paynterf/my_vision_robot/docs/WallE_hotel_Pi5_connection_session_2026-11-04.docx

# Connecting to the Pi 5 from a Hotel Room

Near-verbatim session memorial — 4–6 November 2026

Human = operator, Grok = assistant. Covers direct Ethernet, serial-bridge attempt, cmdline.txt static IP, VS Code Remote-SSH, and iPhone hotspot.

## Initial problem

Human: I'm trying to connect to the Pi5 from my laptop in a hotel room, and it's not working. I suspect this is because the Pi5 wireless adaptor isn't connected to the internet (I was using a local LAN connection in my home). What are my options to get connected?

Grok: You’re right that the Pi is almost certainly still on (or expecting) your home LAN and has no route to the hotel network. Options in order of ease: (1) put the Pi on the hotel Wi-Fi or a phone hotspot, (2) direct Ethernet cable with static IPs, (3) USB gadget mode if pre-configured, (4) pre-arranged Tailscale/ZeroTier. Fastest with a cable is direct Ethernet; fastest with only Wi-Fi is a phone hotspot.

## Direct Ethernet cable

Human: I don't have any cables, but I can get some (I hope). If I have a direct-connect ethernet cable to my laptop, will that be enough to get going?

Grok: Yes. A single ordinary Ethernet cable is enough. Both ends need an IP on the same subnet. Easiest if you can touch the Pi: set 192.168.4.1/24 on eth0 and 192.168.4.2 on the laptop. If you cannot touch the Pi, many systems fall back to link-local (169.254.x.x) and raspberrypi.local may work.

Human: no keyboard/monitor available (unless the laptop can be made into one)

Grok: The laptop cannot become a keyboard+monitor over plain Ethernet. You are limited to a pure network connection. Raspberry Pi OS normally runs Avahi; after plugging the cable try ping raspberrypi.local or scan the 169.254.0.0/16 range. If nothing answers, eth0 is down and you need one-time console access.

## HDMI capture and one-cable reality

Human: you mentioned an HDMI capture device. If I have/get one of those, will that allow me to access the Pi5 via my laptop keyboard/monitor?

Grok: An HDMI capture device gives you the monitor half only. HDMI does not carry keyboard/mouse back to the Pi. You still need a USB keyboard plugged into the Pi (or another input path) to type.

Human: so the best one-cable option is direct ethernet and hope I can ping/connect to the Pi5?

Grok: Yes. With only one cable and no keyboard/monitor, direct Ethernet + hoping for link-local / raspberrypi.local is the best practical option. If nothing responds, you need one-time console access.

## Link-local troubleshooting (after receiving/connecting Ethernet adaptor/cable)

Human: [Windows ipconfig showing Ethernet 2 at 169.254.90.85] ping raspberrypi.local → “could not find host”

Grok: Windows has a link-local address so the cable is linked, but Windows has no mDNS/Bonjour so raspberrypi.local fails. Check arp -a, ping the broadcast 169.254.255.255, or scan with PowerShell. Any answering address can be used with ssh.

Human: [arp -a shows only broadcasts/multicasts on 169.254.90.85]

Grok: No other device is answering at layer 2. Check link lights, reseat the cable, power-cycle the Pi. If ARP stays empty, eth0 is not coming up by itself.

Human: Link light on the Pi5 is ON (blinking). Laptop end is USB-C (no light). Pi5 link light blinks when I ping raspberrypi.local.

Grok: Cable and Pi port are electrically alive. The USB-C Ethernet adapter is the weak link. Confirm it is Ethernet 2, disable power management, try broadcast ping, or set a static address outside the 169.254 range.

## Static IP experiments

Human: [netsh static 169.254.90.10 failed without admin; later with admin produced “PING: transmit failed. General failure.”]

Grok: Windows rejects transmit when you manually assign an address inside the special 169.254.0.0/16 APIPA range. Use an ordinary private subnet instead: netsh interface ip set address "Ethernet 2" static 192.168.4.2 255.255.255.0

Human: [After setting 192.168.4.2, pings to 192.168.4.1 and broadcast time out; arp -a still empty of Pi MAC]

Grok: Laptop side is now working correctly. The Pi simply has no address on 192.168.4.0/24, so it will not answer ARP. The cable is fine; you need one-time console access to give eth0 an address.

## Teensy serial bridge attempt

Human: I actually have a serial adapter - of a sort. I have a USB cable to my Teensy, and the Teensy is connected to Serial1 on the Pi5. Can we generate a teensy program to set the Pi5 ethernet address?

Grok: Yes if a serial getty is running on that UART. Upload a bridge sketch that forwards bytes between Serial (USB) and Serial1. Then use PuTTY on the Teensy’s COM port. If a login prompt appears you can set the IP.

Human: [PuTTY “Access is denied” because Visual Micro had the port open; later black screen, no response to Enter]

Grok: Port is free once Visual Micro shows “Port closed.” Silence usually means no serial console, baud mismatch, or WallE_5.py already owns the port.

Human: I think we forgot that the Pi5 is running the WallE_5.py script from bootup, and it owns the serial port

Grok: Correct. WallE_5.py keeps the UART open, so the bridge cannot give you a shell. Remaining options: mini-HDMI + keyboard, USB-serial on GPIO, or edit the SD card.

## SD card cmdline.txt static IP

Human: OK, I have the SD card plugged into my laptop. It shows up as 'system-boot (D:)'

Grok: That is the FAT32 boot partition. Append to cmdline.txt (single line): ip=192.168.4.1::192.168.4.1:255.255.255.0:raspberrypi:eth0:off The kernel will assign the address at boot.

Human: [Shows cmdline.txt with the ip= parameter added]

Grok: Looks correct. Eject, boot the Pi with the cable connected, then from the laptop (192.168.4.2) ping/ssh 192.168.4.1.

Human: [Screenshot of successful SSH: Welcome to Ubuntu 24.04.4 LTS, pi@RobotPi5:~$]

Grok: You’re in. The ip= parameter worked. You can make it permanent with nmcli or simply leave the cmdline.txt line. Pull the latest code and restart WallE when ready.

## cmdline.txt downsides and VS Code

Human: is there any downside to leaving the ip= line in cmdline.txt?

Grok: Very little for this use case. It overrides DHCP on eth0 only (Wi-Fi unaffected) and is not managed by NetworkManager. Fine to leave for the direct-cable address.

Human: I'm still locked out of VS Code because the Pi5 wifi isn't connectable to the hotel net, correct?

Grok: No. VS Code Remote-SSH works over the Ethernet link. Connect to pi@192.168.4.1. The Pi does not need hotel Wi-Fi for editing.

Human: [VS Code screenshot showing SSH: 192.168.4.1 and WallE_5.py open]

Grok: Connected. Note that the visible terminal may be local; open a new terminal while the remote window is focused to get a shell on the Pi.

## No internet on the Pi / scp

Human: git fetch → fatal: unable to access 'https://github.com/...': Could not resolve host: github.com

Grok: The Pi has no internet path. Options: phone hotspot, Internet Connection Sharing from the laptop, or scp the file from the laptop. For a quick update of WallE_5.py, scp is fastest.

Human: doesn't the scp command need the full laptop path to WallE_5.py as well?

Grok: Yes. Run scp on the laptop with a valid source path, e.g. scp C:\Users\Frank\Documents\Robot_Projects\my_vision_robot\software\scripts\WallE_5.py pi@192.168.4.1:~/my_vision_robot/software/scripts/

Human: [Pastes the full WallE_5.py from the Pi, containing the !STUCK_ACK and !STUCK_CLEAR handshake]

Grok: The copy worked. Handshake code is present and syntactically correct. Restart WallE when ready; Pi and Teensy sides are now aligned.

## iPhone hotspot for untethered testing

Human: I ran into another problem now that I have the PI5 & teensy software aligned. In order to connect the Pi5 to my laptop VS Code I have to have the ethernet cable connected to the laptop, which severely limits how I can test. You mentioned something about using my phone as a local wifi hotspot. Is that a real possibility?

Grok: Yes. Turn on the phone hotspot, nmcli connect on the Pi, then SSH/VS Code from the laptop (also on the hotspot) to the Pi’s 172.20.10.x address. Ethernet can be unplugged once that works.

Human: Will that same trick work with the laptop-Pi5-phone setup; PI5 connects to phone hotspot via wireless, but laptop connects to hotspot via USB-to-iPhone cable connection?

Grok: Yes. On an iPhone the USB-tethered laptop and Wi-Fi hotspot clients share the same 172.20.10.0/28 subnet and can see each other. Laptop internet may prefer the phone; adjust interface metrics if you want hotel Wi-Fi to stay primary.

Human: [nmcli connect “Frank” → No network with SSID 'Frank' found; later scan shows no Frank until Maximize Compatibility]

Grok: Enable Maximize Compatibility on the iPhone (forces 2.4 GHz), toggle hotspot, rescan. Then connect to the stronger WPA2 “Frank” entry.

Human: sudo nmcli dev wifi connect "Frank" password "abc12345" → Device 'wlan0' successfully activated

Grok: Connected. Get the address with ip -4 addr show wlan0, then from the laptop ssh pi@172.20.10.x and point VS Code at the same address. Ethernet cable can come out.

End of memorial. Outcome: direct Ethernet + cmdline.txt ip=192.168.4.1 gave initial SSH/VS Code access; iPhone hotspot (Maximize Compatibility) later provided an untethered path. Handshake code confirmed present on the Pi.
