paynterf/my_vision_robot/docs/WallE_stuck_ahead_handshake_session_2026-11-02.docx

# WallE Stuck-Ahead Debugging & Handshake Implementation

Session memorial — 1–2 November 2026

Near-verbatim record of the debugging conversation. Human = operator, Grok = assistant.

## Opening

Human: This is a continuation of the previous chat, aimed at debugging issues with 'stuck_ahead' processing.

Grok: The stuck-recovery branch is present on the repo. I checked out the current code on that branch and reviewed the relevant sections. [Summary of Teensy RunToDaylightV2 scan + Pi get_stuck_ahead_recovery_heading flow.]

## Floor-run logs and zero distances

Human: New floor run. It appears the stuck_ahead detection and initial motion sequence (stop/reverse/backup/stop) worked OK, but the scan was only partially successful. ... The telemetry.log shows that the first 36 scan output lines look OK, but then the remainder show all zeros for distance. [Full nav.log and telemetry.log excerpts provided.]

Grok: The backup sequence worked cleanly. The scan itself completed, but the front VL53L1X stopped producing valid ranges roughly halfway through the 72-step (5°) spin. First ~36 samples look normal; starting at timestamp 147823 the distance field becomes 0.0 and stays 0.0. Because the open lobe happened to fall in the good half, get_stuck_ahead_recovery_heading still picked a usable middle heading (–145.1°).

## Midpoint / ±180 fold correlation

Human: good analysis, but it doesn't explain why the zero distance readings occur exactly at the midpoint of the scan; that can't be coincidence

Grok: You’re right — it is not a random timeout. It is exactly at the ±180° wrap, which is also the exact midpoint of the 72-step scan. Exactly 36 non-zero readings, then 36 zeros. Last good: 147623 348.9 –179.1; first zero: 147823 0.0 177.3. Starting heading ≈ –4°. 36 × 5° CCW = 180°. The SpinTurn that carries the heading across the fold is the first one that leaves the sensor in the timed-out state.

## UpdateIMUHdgValDeg discussion

Human: How does a heading across the fold possibly influence the sensor itself? Isn't it more likely there is a bug in UpdateIMUHdgDeg()?

Human: why are these two 'while()' statements 'while()' statements instead of 'if' statements? [folding continuousDeg into ±180]

Grok: Those two while loops fold an arbitrarily large unwrapped angle back into [–180, +180]. continuousDeg is an accumulating sum; after many revolutions it can be far outside ±180. A single if would only handle one wrap. The while makes the fold robust. They cannot produce a delay that would affect the VL53L1X (pure floating-point, microseconds at most).

## Root cause: Stuck_Ahead spam

Human: I discovered that the 'Stuck_Ahead' alert from the Teensy was occurring every 50mSec or so, and that was causing most if not all of the issues we were seeing. To address this, I added [STUCK_AHEAD_PRINT_INTERVAL_MSEC = 1000 and rate-limit check]. After these changes, the 'fold' issues disappeared and now scans run correctly. However, this points up a system issue. We already have [recovery_in_progress guard on the Pi]. I think the real solution is to have a handshake arrangement where the Pi5 tells the teensy that it has received the 'Stuck_Ahead' notification and to stop sending these messages.

Grok: The spam diagnosis fits the symptoms perfectly. A !Stuck_Ahead every 50 ms was flooding the serial link and the Pi’s telemetry thread. Rate-limiting to 1 Hz is a solid immediate fix. A real handshake is the cleaner long-term solution. Recommended: Teensy emits only when status is AUTO_NAV (and rate-limited); Pi sends !STUCK_ACK immediately; Teensy sets STATUS_STUCK_AHEAD; after recovery Pi sends !STUCK_CLEAR.

## Switching to AnomalyCode

Human: Looking through my teensy code, it occurs to me that I already have a 'status' code for 'stuck_ahead/behind' with [AnomalyCode enum]. So I think my addition of the 'gl_SystemStatus' object is duplicative and should be dropped. ... I like the idea of a separate "!STUCK_ACK" command... I don't think separate "!STUCK_AHEAD_ACK" and "!STUCK_BEHIND_ACK" commands are required.

Grok: Dropping gl_SystemStatus in favor of the existing AnomalyCode is reasonable. Suggested protocol using gl_AnomalyCode: emit only when ANOMALY_NONE + rate limit; !STUCK_ACK sets ANOMALY_STUCK_AHEAD; !STUCK_CLEAR sets ANOMALY_NONE. Points to watch: manual-mode early-out still needs a replacement; only the Pi should clear the anomaly; optional 60 s safety timeout.

## Risks of dropping gl_SystemStatus

Human: What are the specific risks of dropping gl_SystemStatus?

Grok: Live uses are few but two are load-bearing: (1) loop() early-out for manual/firmware-update — high risk if dropped without replacement; (2) scan abort inside RunToDaylightV2 on manual command — medium risk. Temporary STATUS_STUCK_AHEAD around the scan is low-risk once AnomalyCode handshake is in place. Mitigation: replace with a simple bool gl_bManual or use ANOMALY_MANUAL_CONTROL.

## Header move and compile issues

Human: I have decided to go back to an included 'enums.h' (renamed), but I'm having trouble getting it to compile. [Screenshot of Visual Micro Deep Search error.]

Grok: The failure is happening before the compiler even looks at your code — Visual Micro ‘Deep Search’ library discovery error. Practical fixes: clear %LOCALAPPDATA%\Arduino15\staging and Temp\VMBuilds; turn off Deep Search; ensure header is in the sketch folder; simplify the header guard to just #pragma once.

## Git commit / diff workflow

Human: I am getting ready to commit the latest firmware update to Github. ... the 'diff' now showed NO CHANGES! How do I view the actual changes between the Github repo and my (staged but not committed) files?

Grok: Once everything is staged, plain git diff is empty by design. Use git diff --cached (or --staged) to see staged changes vs HEAD. In Visual Studio, ‘Compare with Unmodified’ diffs working tree vs HEAD (shows all local changes); ‘Compare with Index’ shows only unstaged.

## Review of commits

Human: OK, I think I got the latest firmware update committed/pushed. Can you take a look at the Github repo and tell me what I got wrong or missed?

Grok: Commit 5e65691: real bug in new header — enum/array mismatch (ANOMALY_MIRRORED_SFC still in enum, string array dropped it). gl_SystemStatus was not removed. Rate limit and IMU correction restore look correct.

Human: good points - I fixed the enum index issue. regarding gl_SystemStatus vs gl_AnomalyCode; I've changed from gl_SystemStatus to gl_AnomalyCode, but wonder if I should also keep the 'FIRMWARE_UPDATE' status/code (make it another entry in the AnomalyCode enum?

Grok: No — you do not need to add FIRMWARE_UPDATE. It is never assigned in live code; the ‘U’ handler calls update_firmware() which does not return on success and reboots on failure. Drop it.

## Final handshake implementation

Human: So in the 'M' case, this needs to be: gl_AnomalyCode = AnomalyCode::ANOMALY_MANUAL_CONTROL; and in the 'A' case: gl_AnomalyCode = AnomalyCode::ANOMALY_NONE; Does that look correct? [Then proposed !STUCK_SCAN clearing immediately.]

Human: I like the latter approach, with full handshaking. We are not concerned about about speed at all - just consistency and robustness

Grok: Full handshake: Teensy emits only when ANOMALY_NONE + rate limit. !STUCK_ACK sets ANOMALY_STUCK_AHEAD. !STUCK_SCAN sets it (idempotent) and does not clear. !STUCK_CLEAR is the only place that sets ANOMALY_NONE. Pi sends ACK first, then backup + SCAN, then CLEAR after turn/restart.

## Commit reviews and Visual Studio notes

Human: should be up on GitHub. Can you please check?

Grok: Commit 0aa3bd7 looks correct. Header mismatch fixed, full handshake commands present, SystemStatus removed, M/A and scan-abort updated. Minor: print strings still say “System Status”; Pi side not yet updated in this push.

Human: I've noticed that the Visual Studio version of 'commit/push' seems to bypass 'fetch/status/pull/status'. Is that an issue?

Grok: Yes, it can be an issue if the remote has moved. VS Commit/Push does not automatically fetch or pull. Fine when you are the sole committer and recently pulled; otherwise fetch first.

Human: [Diff view screenshot] This is the Visual Studio 'diff' view, but it doesn't seem to offer an easy way to go from there to the 'changes' page... Am I missing an easier way?

Grok: No hidden button on the diff tab. Fastest: Ctrl+0, G then C, or Git → Commit or Stash…. Dock the Git Changes window so it stays available.

Human: oooh, thanks - I docked it into the bottom of the Solution Explorer window

## Final commits and close

Human: the last changes should be up on Github

Grok: Commit cc73fb2: three print-string updates only. One nit: commented line used AnomalyCodeStrArray instead of AnomalyStrArray.

Human: No, I meant it has already been fixed and should be up on Github - sorry for the confusion

Grok: Confirmed. Commit b073ab6 fixes the commented line to AnomalyStrArray. Name matches the header.

Human: This evening's work was kind of fun. I've never been able to iterate through things at all quickly like this. Having you watching over my shoulder is really powerful.

Grok: Glad it felt that way. The tight loop—change, push, review, next fix—works well when both sides can see the same repo state quickly.

End of memorial. Key outcome: Stuck_Ahead spam identified as root cause; full handshake implemented on Teensy using AnomalyCode (!STUCK_ACK / !STUCK_SCAN / !STUCK_CLEAR); SystemStatus removed; rate-limit retained as backstop.
