paynterf/my_vision_robot/docs/WallE_best_direction_discussion_2026-10-09.docx

WallE floor-test discussion

Best direction after TOO_CLOSE

9 October 2026

Verbatim discussion, beginning with the 15° scan-interval note. Speaker labels are added. The wording is otherwise as sent.

# Discussion

Human

After thinking about it, I'm not sure the 15 deg scan intervals will help much. As you pointed out yesterday, the FOV overlap even at 45 deg intervals means a 15 deg scan interval will not provide any additional information.

Human

Thinking aloud here; the problem we are trying to solve is "what is the best direction to move after encountering a 'too close' obstacle"? We use the OAK-D Lite camera to produce a coarse 2D (off-angle and depth) array. From this array we select the best off-angle/depth pair for each orientation in an 8-position (initial heading plus seven 45 deg scan steps). At the end of the scan we have a catalog of robot headings /best-depth pairs. From that we pick the best depth and tell the robot to turn to the associated heading. We have found so far that this algorithm doesn't always pick the 'correct' heading in an office environment with lots of clutter, but with an obvious open direction with an approximately 7m clear run. This leads me to believe that either we do not have a good definition of 'best direction’ or our sensor is incapable of distinguishing between 'under the desk past my legs' and 'doorway 7 meters away', or we are not utilizing our sensor information appropriately. As you just mentioned, a better 'best direction' definition might be your "A direction worth driving is the heading whose central strip is far, and whose neighbors are also far. One bright pixel at the edge of the frame is not that."

Grok

The 15° scan would mostly resample the same frames. With a 72° stereo field of view, a stop already sees the neighbor's scene, so tighter steps add copies, not a new direction.

Grok

The break is in what "best" means. The catalog keeps the farthest pixel in each frame, then turns to the heading that held the single largest of those. In this room that pixel is often a gap under a chair, or the doorway already in the edge of the frame, one stop before the robot is aimed at it. A 7 m clear run only wins if some frame's farthest pixel happens to be that run, and the heading stored with it happens to be the one pointing down it.

Grok

So the two separate faults are the score and the pairing. The score is "farthest pixel anywhere," not "longest clear path straight ahead." The pairing is the heading filed with that pixel, which across the three runs did not stay on the doorway: 3379 mm, 1386 mm, and 1772 mm for the same south opening.

Grok

A direction worth driving is the heading whose central strip is far, and whose neighbors are also far. One bright pixel at the edge of the frame is not that.

Human

Human

This leads to the conclusion that just picking the 'best-depth' associated with a scan stop is not sufficient for robust 'best-direction' determination. The good news; we actually have more information available from even the coarse algorithm we are currently using. Each 'best-depth' value is also paired with an 'off-angle' value that denotes how far off from the camera's central axis the best-depth value is located - this is what we use for 'tweak right'/'tweak left' adjustments. So, if we wished, we could replace the single 'best-depth' value in our scan catalog with an array containing *all* of the depth values available for each scan position. Due to the overlap caused by a 45 degree scan interval and a ~70 FOV, we might even be able to stitch the separate depth value arrays into a more-or-less seamless 'horizon depth array' that could make finding the real 'best direction' much more robust.

Human

As a possible variation on your "A direction worth driving is the heading whose central strip is far, and whose neighbors are also far. One bright pixel at the edge of the frame is not that." In my old robot's firmware I used a mathematical variance calculation of front & rear distance values to robustly determine when the robot was stuck; during normal operations, the front and rear distances vary linearly as the robot tracks a wall. When the robot gets stuck, the distances no longer vary. A variance calculation at each pass through the navigation loop will detect 'stuck' by noting that the variance has decreased below some threshold. If we were to construct the 'more or less seamless' array of depth values around the horizon, the 'best direction' would be the one that has a relatively smooth progression of depths up to peak and down again.

Human

So, to summarize my ramblings; I propose that we utilize the entire (or a subset of) the 'horizon' depth value array available from the camera at each scan orientation to make a better determination of 'best direction'.

Human

One other off-beat but possibly relevant piece of data. We actually have a second independent distance sensor in the rear-facing VL53L1X IR TOF sensor. Maybe it could be used as a sanity check and/or a way to filter out the 'under the chair past my legs' orientation.

Human

Thoughts?

Grok

The horizon array is the right next representation. The single best-depth is what has been losing, and you already have the off-angle that says where that pixel was.

Grok

A stitched circle is only as good as the heading on each frame. That pairing is the thing the three runs did not hold: the doorway came back as 3379 mm, 1386 mm, and 1772 mm. If a frame is filed one stop off, stitching smears the 7 m opening into the wrong sector and makes the miss look smooth. Per stop, keep the angle-and-depth samples in camera axes. Convert to world heading only after the H for that stop is in. Do not stitch until a stop aimed at the doorway keeps the long reading.

Grok

The variance idea is the part that rejects the chair gap without stitching. A doorway is a wide lobe: several off-angles far, and the neighbors far too. Under the desk is a narrow spike, one far pixel with near pixels beside it. Score each stop by the width of the far region around the center, not by the maximum. The peak of a smooth run is the direction. A lone 2968 mm at the edge of the frame loses.

Grok

The rear VL53L1X can be a veto, not the selector. It is one narrow beam, 180° from the camera. At a real doorway stop the camera's central strip is far and the rear beam is the wall just backed away from. At the legs stop the camera's far pixel is off-axis and the rear beam is not a wall. Sample it at the same pause as the H. If the rear range is long too, that stop is a gap, not an exit.

Grok

So the catalog row becomes the central depth, the width of the far region, and the rear range. The winner is the wide, central, rear-near stop. The 15° scan can wait until that score picks south on a 45° run.

Human

"The rear VL53L1X can be a veto, not the selector. It is one narrow beam, 180° from the camera. At a real doorway stop the camera's central strip is far and the rear beam is the wall just backed away from. At the legs stop the camera's far pixel is off-axis and the rear beam is not a wall. Sample it at the same pause as the H. If the rear range is long too, that stop is a gap, not an exit."

Human

I like the 'veto' idea, but it's not just a veto. When the robot is pointing away from the doorway, the rear sensor is pointing toward it. A good measure of 'best-direction' would be the direction that produced multiple far-distance values in that (or adjacent?) scan stop *and also* with a correlated high distance value from the rear sensor reading associated with the opposite scan direction (i.e. the scan direction where the rear sensor is pointed in the same direction as the 'best-direction' candidate). Maybe that is really the same as the 'veto' idea - inverted?

Human

Also, since the VL53L1X is very fast, we could actually use it to produce a much more granular map of a candidate direction by rotating the robot 180 deg and smoothly rotating the robot through the directions of interest. And now that I think about it- that sensor doesn't have to be rear-facing; I could just as easily mount it facing in the same direction as the camera, and then it becomes an accessory-during-the-fact collaborator.

Human

"The winner is the wide, central, rear-near stop" I believe you let an assumption sneak into this sentence; the 'best-direction' doesn't have to be 180 degrees from the obstacle. The robot could just as easily hit a chair just past a long hallway, where the 'best-direction' is 90 degrees from the obstacle orientation. In the limit, think of a 'Tee' intersection (except the horizontal cross-bar is longer than the vertical portion) where the robot is traveling from the bottom of the 'Tee' toward the top. the robot reaches the top of the T intersection and hits the far side. Then *either* 90 degree direction would work> So the catalog row becomes the central depth, the width of the far region, and the rear range. The winner is the wide, central, rear-near stop. The 15° scan can wait until that score picks south on a 45° run.

Grok

Yes. The rear-near rule was the wrong geometry. It only fits this room, where the robot backed off a wall and the doorway was behind it. At the top of a T, both exits are 90° from the wall it hit, and the rear beam at either exit stop is the other exit, not a wall. A long rear reading there would veto the right answer.

Grok

The useful pairing is the opposite stop. A candidate heading is confirmed when the camera's wide central lobe points that way and the rear beam, taken at the stop 180° around, also sees far down that same line. That is the veto inverted: the rear sensor votes for a direction while it is aimed at it, not while the camera is. Adjacent stops can vote too, since the beam is narrow and a stop may not land on the opening.

Grok

Mounting it forward makes that simpler. It then samples the same direction as the camera, at the same pause as the H, and a far central lobe plus a far beam is one stop instead of a pair. A smooth 180° sweep with the VL53L1X is a good way to draw the lobe once a candidate exists. It is a poor whole-room scan: one narrow beam misses a doorway that the 72° camera only catches off-axis.

Grok

The row is the central depth, the width of the far region, and the range along that same line from the other sensor. The winner is the wide lobe, wherever it sits relative to the obstacle.

Human

Can an item in the scan catalog object be *all* of the horizon-level depths associated with a scan position? Would that help or be overkill?

Grok

Yes, and it is the useful amount, not overkill, if the item is the horizon bins and not the frame.

Grok

A stop already produces a set of off-angle and depth pairs. Storing that set on the catalog row is what lets you score width instead of one pixel. Eight stops, and something like a depth every 5° across the 72° frame, is under 120 numbers. That is nothing next to a depth image.

Grok

What would be overkill is keeping every pixel, or stitching those rows into one circle before a doorway stop has held its own long reading. Keep each row in camera angles, with the H for that stop. Width and central depth come from the row. The winner is the row whose far bins cluster around zero off-angle, not the row that contains the single largest number.

Human

"The winner is the row whose far bins cluster around zero off-angle, not the row that contains the single largest number"

Human

What if the doorway area gets split between two scan positions? Then the peak will be fully off-axis in *both* 'horizon-level' depth arrays. I think you *have* to stitch the depth arrays together - at least conceptually - in order to handle that case. I think the only real way to avoid that necessity is to go back to the 15 deg scan interval idea, with the thinking that the 'stitching' would be done more or less automatically.

Grok

The split case needs the stitch. A doorway sitting between two stops is off-axis in both rows, so "cluster around zero" picks neither, and the single largest pixel picks whichever edge happened to be farther.

Grok

With a 72° frame and a 45° step, that opening is in both rows at known off-angles. Putting those bins on one circle, at heading plus off-angle, places the peak between the stops. The turn target is that peak, not either stop heading. That is the stitch, and it is required for the 45° grid.

Grok

The 15° grid only hides the problem. A stop then lands closer to the opening, so the central-bin score usually wins without an explicit join. The same doorway is still in several rows, and the peak can still fall between two of them. Finer steps make the miss smaller. They do not remove it.

Grok

The earlier caution stays on the pairing, not on the stitch. Heading plus off-angle is only the right world angle if that H belongs to that frame. A one-stop mix-up moves the whole lobe 45°. So stitch adjacent rows, and check that a stop aimed at the doorway still holds the long bins before trusting the joined peak.

Human

"The earlier caution"? By this do you mean our prior observation that the known physical orientation of the doorway didn't seem to match up with the 'H' value associated with the larger depth values? If so, I think we might be able to solve that problem with multiple camera reads for every scan step; maybe three reads, discarding the first two?

Grok

Yes. That caution is the doorway not holding its own long reading: 3379 mm, 1386 mm, and 1772 mm on three runs aimed south, and the 1600 mm wall showing up on the next stop. The logged frame ages were all under 0.03 s, so it did not look like a half-second-old frame. A frame left over from the turn is still possible.

Grok

Three reads at the stop is a direct test of that. The first message after the pause can still be the previous orientation, or a frame exposed while the robot was moving. Dropping the first two and keeping the third gives the camera time to publish a frame from the stopped orientation. Log all three, with the off-angle, so a discarded read that was the long one is visible.

Grok

If the third read at the south stop is the 7 m opening and the first is the short one, the pairing was a stale frame and the stitch can use the third. If all three are short while the robot is aimed at the doorway, the frame is current and the miss is the score: the farthest pixel is not the opening. That result is worth having before building the joined horizon.

Human

"...before building the joined horizon." Did you mean "... before going to the (probably non-trivial) trouble to build the joined horizon"?

Grok

Yes. The three-read test is a small change. The joined horizon is the larger one, and it is not worth building until a stopped south reading holds the doorway.

# Summary

The discussion settled on a score, a representation, and a small test. It did not settle on building the joined horizon yet.

## The problem

After a TOO_CLOSE stop, the robot needs a direction worth driving. The current scan takes an initial heading plus seven 45° steps. At each stop it keeps one best off-angle and depth from the OAK-D Lite, then turns to the heading that held the single largest depth. In this office that has not reliably selected the obvious doorway, a roughly 7 m clear run.

## What the three floor runs showed

The headings label the stopped orientation. The depths filed with them do not stay on the doorway. The south opening came back as 3379 mm, 1386 mm, and 1772 mm. In run 2 the 1600 mm wall behind the PC was stored one stop after the legs orientation. In run 3 the 2968 mm winner was one stop before due south. Logged frame ages were all under 0.03 s. The last catalog bin was 0 mm in runs 2 and 3.

## Why 15° steps are not the fix by themselves

The stereo field of view is about 72°, and some OAK-D sheets put it at 80°. A 45° step already overlaps the next stop, so a 15° step mostly resamples the same scene. Finer steps make a miss smaller. They do not give a new direction, and they do not stop a doorway from falling between two stops.

## Two separate faults

The score is "farthest pixel anywhere in the frame," not "longest clear path straight ahead." A chair gap or the doorway already in the edge of the frame can win. The pairing is the heading stored with that pixel. A one-stop mix-up moves the whole reading by about 45°.

## The agreed representation

A catalog row can hold the horizon bins for that stop, depth against off-angle, not the whole frame. Eight stops at about 5° across a 72° frame is under 120 numbers. Width of the far region is the score. A doorway is a wide lobe. Under the desk is a narrow spike. One bright pixel at the edge is not a direction.

## The stitch

A doorway split between two stops is off-axis in both rows, so a per-row "cluster around zero" score picks neither. The rows have to be joined, at least conceptually, at heading plus off-angle. The turn target is the peak of that joined lobe, not either stop heading. The 15° grid only hides this. It does not remove it.

## The pairing caution

Heading plus off-angle is the right world angle only if that H belongs to that frame. Stitching a mis-filed frame smears the 7 m opening into the wrong sector and makes the miss look smooth. That is the earlier caution: the known doorway orientation did not hold the large depth.

## The cheap test, before the joined horizon

Three camera reads at each stopped scan step, logging all three with off-angle, and keeping the third. If the third south read is the 7 m opening and the first is short, the pairing was a stale frame and the stitch can use the third. If all three are short while aimed at the doorway, the frame is current and the miss is the score. The joined horizon is the larger job, and it waits on that result.

## The second sensor

The rear-near rule was the wrong geometry. It only fits a robot that backed off a wall with the doorway behind it. At the top of a T, both exits are 90° from the obstacle, and a long rear reading there would veto a good exit. The useful vote is the range along the candidate line: the rear VL53L1X at the opposite stop, or the same sensor mounted forward and read at the same pause as the H. A smooth 180° sweep can draw a lobe once a candidate exists. One narrow beam is a poor whole-room scan. The winner is the wide lobe, wherever it sits relative to the obstacle.

WallE · best direction after TOO_CLOSE
