paynterf/my_vision_robot/docs/WallE_freshness_and_clear_direction_troubleshooting_2026-10-12.docx

# WallE Vision-Enhanced Robot — Frame Freshness & Clear Direction Troubleshooting

Near-verbatim chat memorial, 10–12 October 2026

Labels: Human = operator, Grok = assistant. Literal command sequences are indented and shown in #008000 green.

## Transcript

Human: New chat for Vision-Enhanced Robot Development... dedicated to testing frame freshness with multiple best_depth measurements.

Grok: Isolated experimental path via file copies recommended so mainline stays untouched.

Human: Start with 3 steps: one before, one at, and one after the doorway heading (two L45s, start 45° CW of doorway).

Grok: Agreed. Log all three reads at each stop. 'auto' runs only the freshness test.

Human: How do we isolate so we don't contaminate mainline? File-copy habit vs Git branch?

Grok: Both work. Branch is cleaner long-term. Example:

git switch -c score-mode-experiment

# edit, commit, push

git switch vision-to-motion-demo

Human: Created WallE_5_freshness.py and restart-walle-freshness.sh. Smoke test OK.

Grok: Replace 'auto' handler to call only run_freshness_test().

Human: [Freshness log] Ages < 0.03 s, all edge sectors, depths 1.3–1.8 m.

Grok: Freshness not the cause. Score still picking moderate edge gaps.

Human: [Videos] Doorway and >10 m column visible.

Grok: Camera saw it; node did not report it.

Human: [VL53L1X forward] 3.5–4 m through doorway when parallel to floor.

Grok: VL53 sees the opening. Bottom-half stereo average does not.

Human: Two scoring modes without restart?

Grok: Yes — ROS parameter, re-read each callback.

Human: Created find_clear_direction_troubleshooting branch.

Grok: Edits stay on that branch only.

Human: [Middle-third band] Bench: multi-meter + central. Floor: mostly short, one near-central sector. VL53 still long.

Grok: Band raise helps bracketing. Floor depths still short.

Human: Three floor stops: turn left 31 / you are there / turn right 31.

Grok: Coherent doorway bracket.

Human: LIDAR superior for TOO_CLOSE. Suggest LIDAR first pass + vision if ambiguous. Long-term: lightweight map. Commit troubleshooting, start stuck-recovery.

Grok: Agreed. Exact sequence:

# make sure the troubleshooting branch has everything you want to keep

git status

git add -u # or explicit paths

git commit -m "Middle-band experiment and freshness-test results"

git push

# leave that branch as the record of the camera-scoring work

git switch vision-to-motion-demo

git switch -c stuck-recovery

Grok: troubleshooting branch becomes the archive. stuck-recovery starts clean for LIDAR-primary recovery.

Human: What does git add -u do?

Grok: Stages changes to already-tracked files only; leaves untracked freshness copies alone.

## Summary

Freshness ruled out (ages < 0.03 s). Doorway was in view but stereo node returned short edge averages. Forward VL53L1X reported 3–4 m. Bottom-half crop hid the opening; middle-third improved direction but not absolute floor depth. For recovery use VL53 variance detector + longest-range scan; camera for corroboration. Doglegs need memory. Git commands above are now #008000 and indented.

End of memorial.
