paynterf/my_vision_robot/(list of files, drawings)

Other design files:
docs/2Wheel-to-4Wheel-Move/260709_PololuD24V50FSReg_Adafruit1NA169.dch
docs/2Wheel-to-4Wheel-Move/260710_5VReg.dip
docs/2Wheel-to-4Wheel-Move/260710_5VRegulator.dip
docs/2Wheel-to-4Wheel-Move/260712 VisionEnhancedRobotSchematic.dch
docs/2Wheel-to-4Wheel-Move/260714_5VRegulator.dip
docs/2Wheel-to-4Wheel-Move/260716 VisionEnhancedRobotSchematic.dch
docs/2Wheel-to-4Wheel-Move/260718_5VRegulator.dip
docs/2Wheel-to-4Wheel-Move/260718_5VRegulatorNonBlock.dip
docs/2Wheel-to-4Wheel-Move/260718_PololuD24V50FSReg_Adafruit1NA169.dch
docs/2Wheel-to-4Wheel-Move/260728 VisionEnhancedRobotSchematic.dch
docs/2Wheel-to-4Wheel-Move/260801 VisionEnhancedRobotSchematic.dch
docs/2Wheel-to-4Wheel-Move/260812 Teensy3p5_VisionEnhancedRobotSchematic.dch
docs/2Wheel-to-4Wheel-Move/260812 VisionEnhancedRobotSchematic.dch
