paynterf/my_vision_robot/(commit log)

2026-06-01 Cleanup: Remove duplicated common/ folder - now using external Teensy_OTA_Base
2026-06-04 Updated with new TeensyOTA1.ttl and board.txt (symlinks to Teensy_OTA_Base)
2026-06-05 Simple Serial Passthrough test Teensy sketch on the Teensy and corresponding Python script on the Pi5
2026-06-27 Update include paths in teensy_main.vcxproj
2026-06-27 Add documentation and test folders (Pi5 + Teensy)
2026-06-28 Add Wifi_OTA.py wireless upload tool
2026-06-28 Add software/Wifi_OTA directory with wireless OTA tool and related files
2026-06-28 Restructure: Move SerialPassthroughDemo into software/ with pi5/teensy subfolders
2026-06-29 Restructure: Move Wifi_OTA Teensy project + Python script into software/Wifi_OTA with pi5/teensy subfolders
2026-07-02 Update Windows project structure and OTA build system - Re-created Wifi_OTA VS/VM project, fixed board.txt/PostBuild paths, verified full end-to-end OTA
    [Wifi_OTA.py]
2026-07-02 Update Wifi_OTA Teensy project: LED blink on startup for easier verification
2026-07-02 Remove old backup folders from Wifi_OTA Teensy project
2026-08-07 Adding new 'VisionEnhanced4WheelRobot' Arduino project to the 'my_vision_robot' repo 'vision-to-motion-demo' branch
2026-08-08 Revised CheckForUserInput() functions to allow the Pi5 to inject commands via Serial1. Also commented out a bunch of debug printout lines
2026-08-10 added telemetry logging to capture anything received on serial port (from Teensy Serial1)
2026-08-17 Complete working firmware after reverting back from Teensy 4.1 to Teensy 3.5. Added TeePrint.h for dual-target telemetry/debug output
    [VisionEnhanced4WheelRobot.ino]
2026-09-02 multilateral 'tee' telemetry streams, rear distance and variance, 'stuck behind' detection
    [VisionEnhanced4WheelRobot.ino]
2026-09-02 tmux 2-pane status display, camera/vision/supervisor services, basic vision-controlled robot turns
2026-09-08 Added timestamps to CCW/CW turn printouts in CheckForUserInput()
2026-09-14 Added L/R speeds to telemetry removed some commented-out lines bugfix to SetLeft/RightMotorDirAndSpeed() to update gl_Left/Rightspeednum Added gl_pSerPort->printf(F("Tddd.d = Turn to heading ddd.d\n"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
    [VisionEnhanced4WheelRobot.ino]
2026-09-14 Changed from tmux-style log monitoring to separate telemetry and WallE_5.py log files Moved delay handling from Teensy to WallE_5 Added send_nav_seq(steps, reason), where 'steps' is an array of strin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
2026-09-18 Handshake only on sequenced L/R turns; new NAV_SEQ_CONTINUE_ON_FW_ABORT = True allows for full command sequence bench testing (robot on blocks or motors disabled). Set to 'False' for real field testi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
2026-09-24 More bugfixes, more debug logging output
    [VisionEnhanced4WheelRobot.ino]
2026-09-24 more consistent function naming, bugfixes
    [WallE_5.py]
2026-09-26 Changes to accommodate new Teensy 'flat' (single-layer) command hierarchy
2026-10-09 Floor-test firmware and notes, 2026-10-09" #define NO_TELEMETRY //added 09/24/26 #define IMU_HDG_CORRECTION_FACTOR 0.753405824 //added 10/03/26, rev 10/07/26 for better correction //float gl_IMUHdgVa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
2026-10-14 Stuck Ahead detection with front LIDAR now working
2026-10-28 Updated 'TEENSY_TIME' section in telemetry_loop(), updated strip_teensy_ts(), added 8 cmd to initial 'stuck_ahead' cmd seq
2026-10-28 Added call to InitFrontDistArray() to 'stuck_ahead' case in CheckForUserInput()
2026-11-03 added my_vision_robot_enums.h to avoid VS intellisense errors, and removed all inline enums. Added IMU heading correction back in (it was removed as a possible culprit in the 'Stuck_Ahead' spam issue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
2026-11-03 Cleaned up some debug printout issues - no code changes
2026-11-03 Fixed one more typo in a commented-out debug print line. Nice catch Grok!
2026-11-11 Add obstacle-ahead handling in WallE_5.py and minor Teensy updates
