paynterf/my_vision_robot/docs/2Wheel-to-4Wheel-Move/IMG_7026.JPG

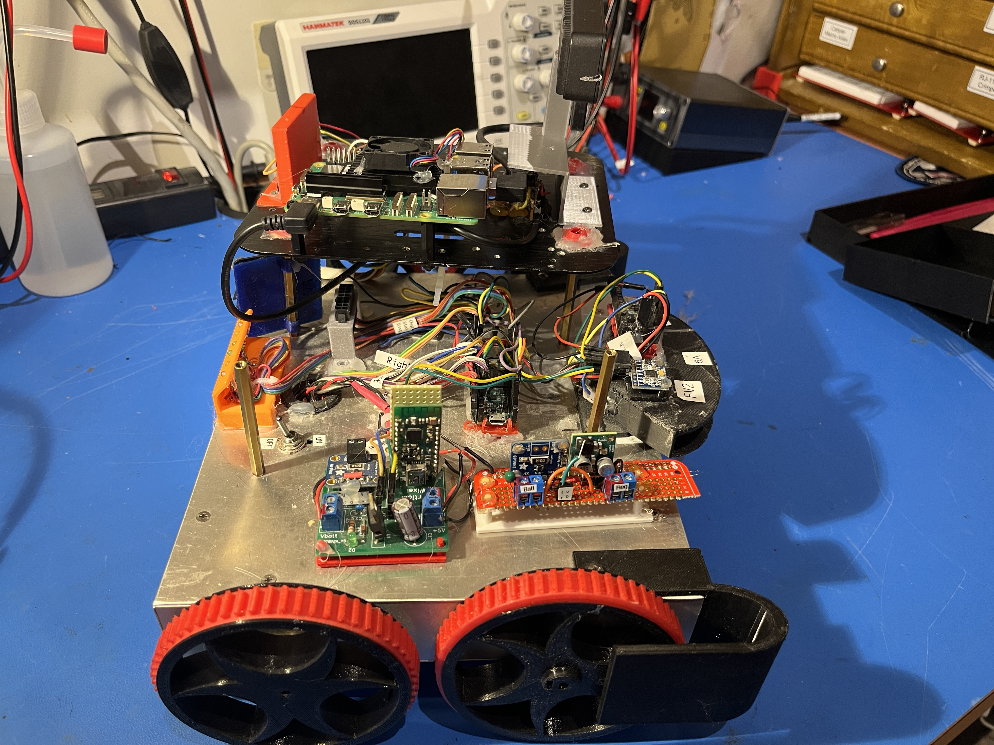
docs/2Wheel-to-4Wheel-Move/IMG_7026.JPG
